andkorzh/FPGA-DENDY/README.md

# FPGA-DENDY
Cycle-accurate FPGA project for an 8-bit game console, created through reverse engineering of the original chips NES (Famicom).

Available operating modes of the NTSC, PAL, and DENDY

Prototype for Cyclone II



Video on YouTube

https://www.youtube.com/watch?v=XWy88H4eIGA

Resources used by FPGA

FPGA_DENDY_RES

Version on FPGA Lattiсe LCMXO2-4000HC

FPGA_DENDY_LAT



Video on YouTube  

https://www.youtube.com/shorts/M_W1QgEvRp8

Resources used by FPGA Lattice LCMXO2-4000HC

Lattice res
