andkorzh/FPGA-DENDY/PCB/Cyclone PCB/readme.md

Once verified, the PCB Gerber files will be added to the repository shortly.
