andkorzh/FPGA-DENDY/PCB/Cyclone PCB/FPGA_DENDY.PNG

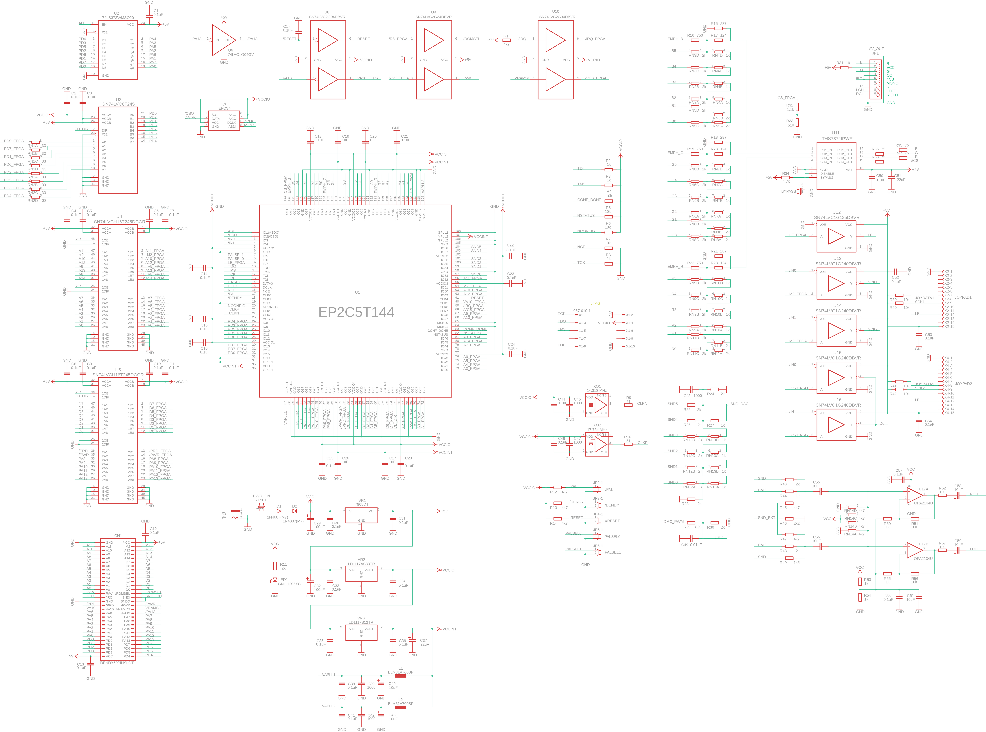
PCB/Cyclone PCB/FPGA_DENDY.PNG
