andkorzh/FPGA-DENDY/(notices)

Notices in the files:
Verilog/FPGA_DENDY.v:
modify it under the terms of the GNU General Public License
parts and their libraries:
crystal-geyer_V1_0: Copyright: Geyer-Electronic
